william-in-kit/opencv-robot/IMG_3364.JPG

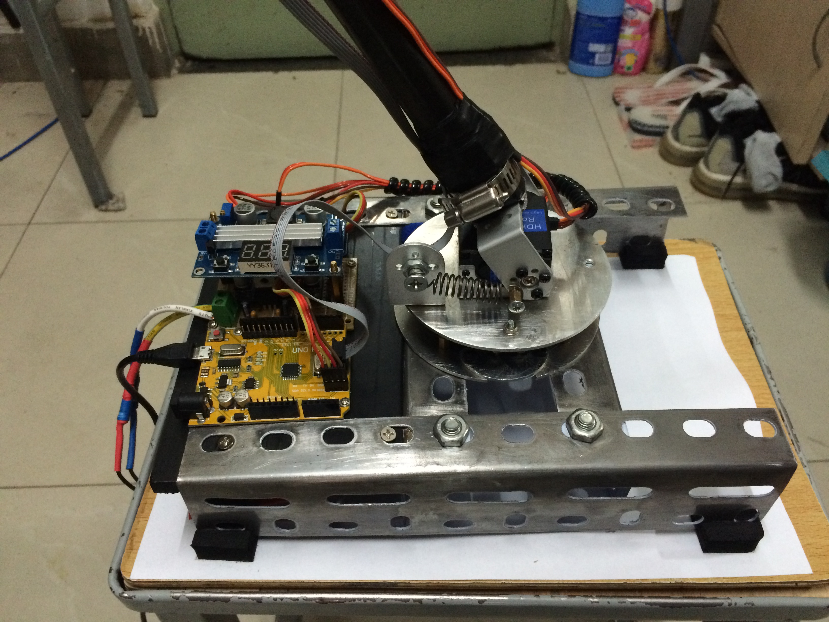
IMG_3364.JPG
