william-in-kit/opencv-robot/IMG_3276.JPG

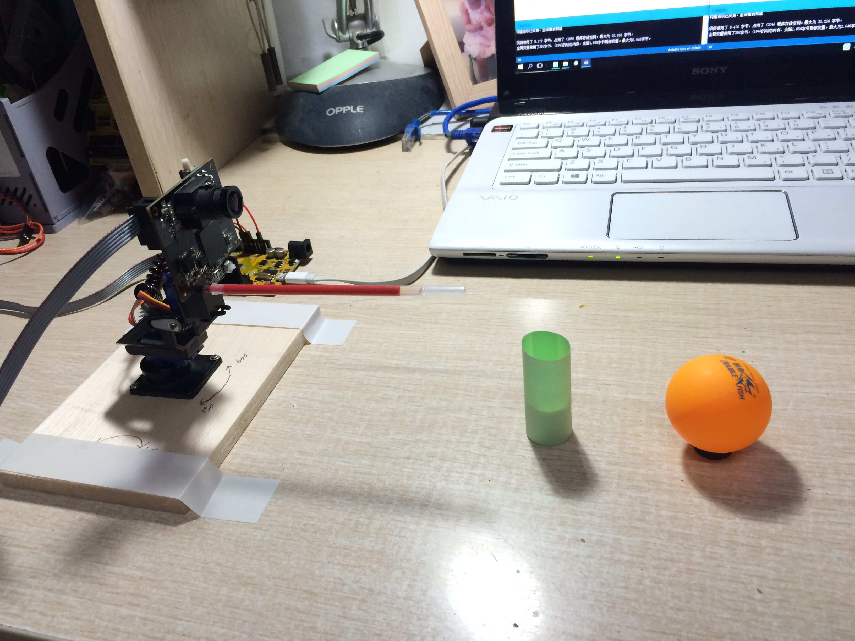
IMG_3276.JPG
