william-in-kit/opencv-robot/IMG_3359.JPG

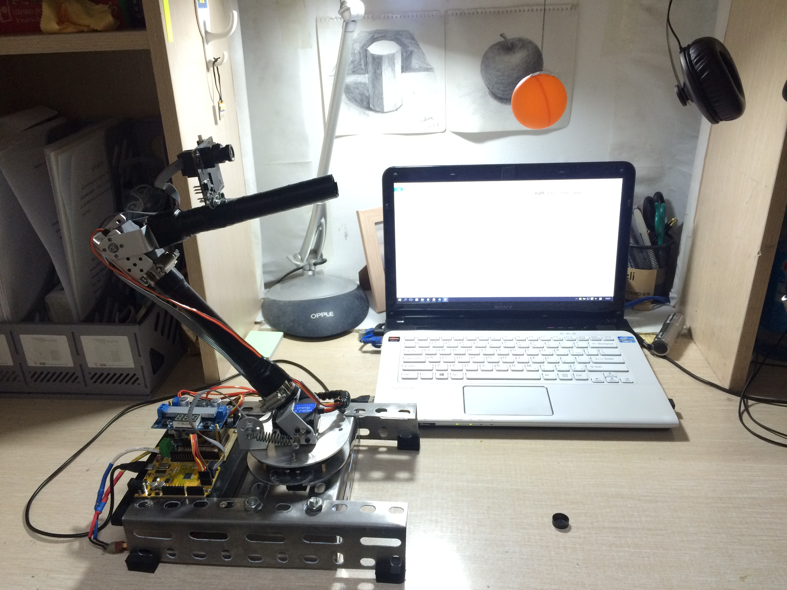
IMG_3359.JPG
